maxwellfairman/EMG-Signal-Conditioning-and-Monitoring-System/EMG circuit testing/Rectified Signal.jpg

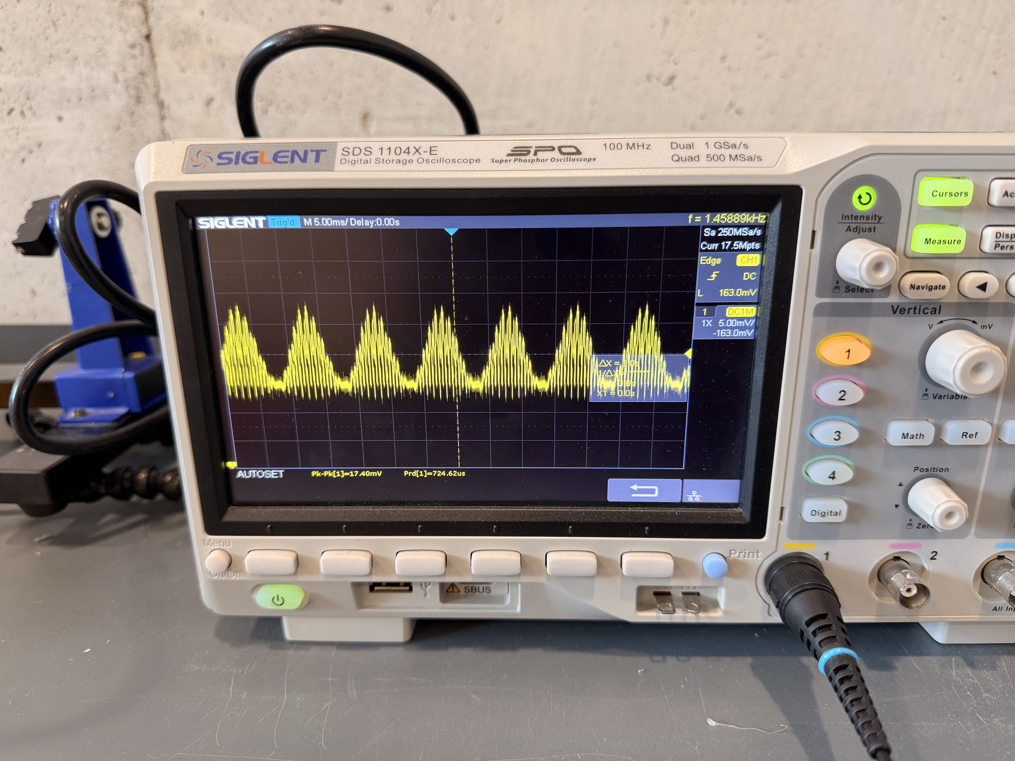
EMG circuit testing/Rectified Signal.jpg
