maxwellfairman/EMG-Signal-Conditioning-and-Monitoring-System/EMG circuit testing/Signal after lowpass filter.jpg

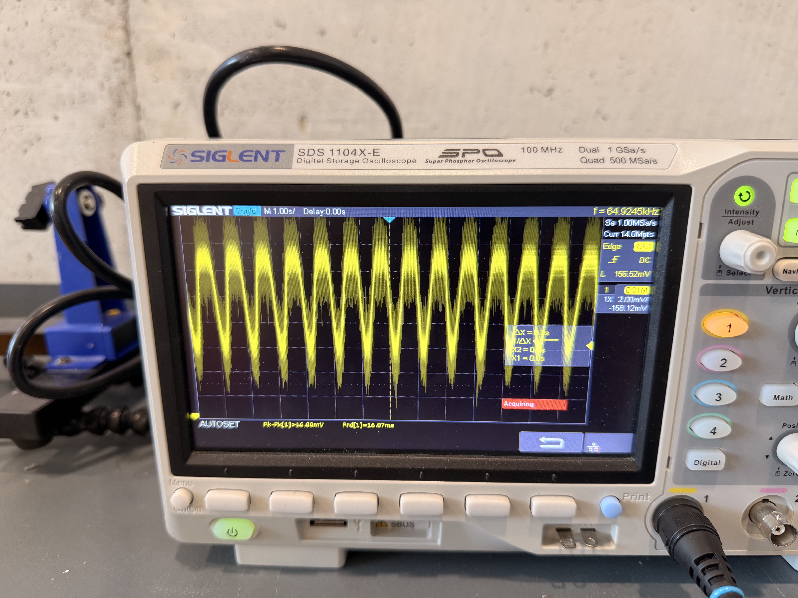
EMG circuit testing/Signal after lowpass filter.jpg
