maxwellfairman/EMG-Signal-Conditioning-and-Monitoring-System/EMG LTSpice simulations/Circuit diagram.png

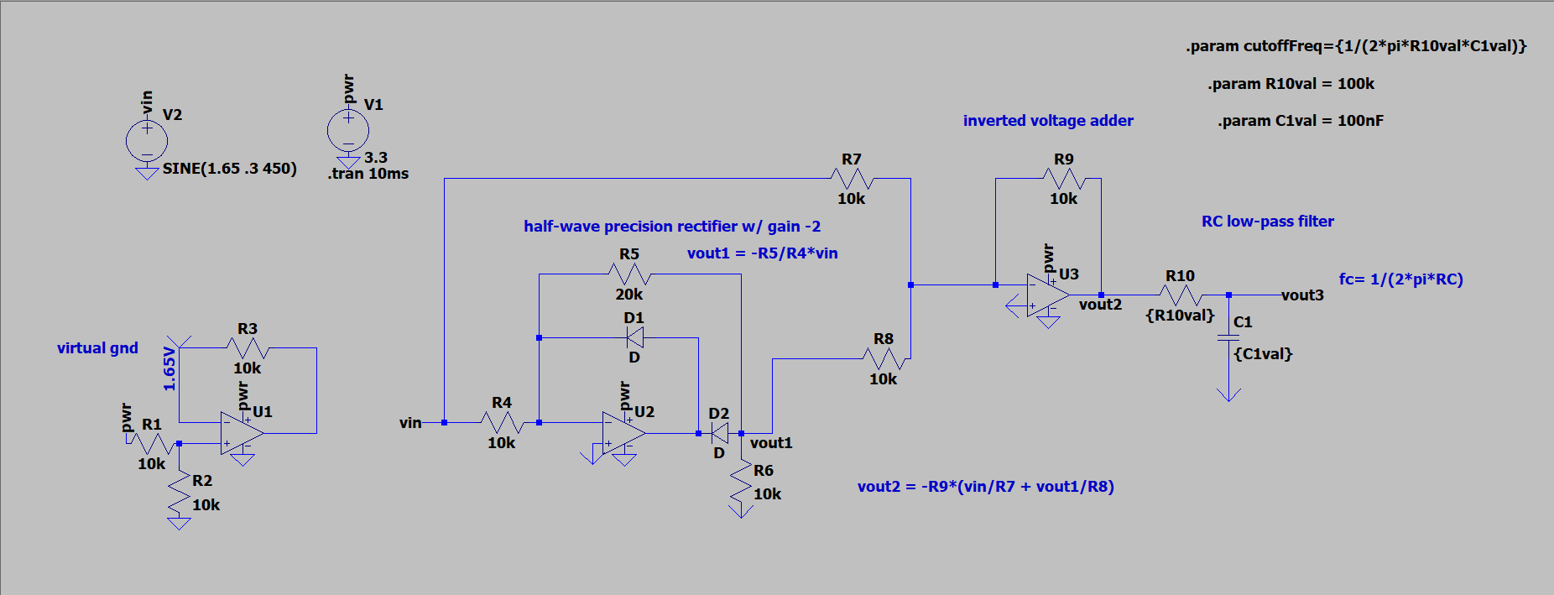
EMG LTSpice simulations/Circuit diagram.png
