maxwellfairman/EMG-Signal-Conditioning-and-Monitoring-System/EMG LTSpice simulations/Transient Analysis.png

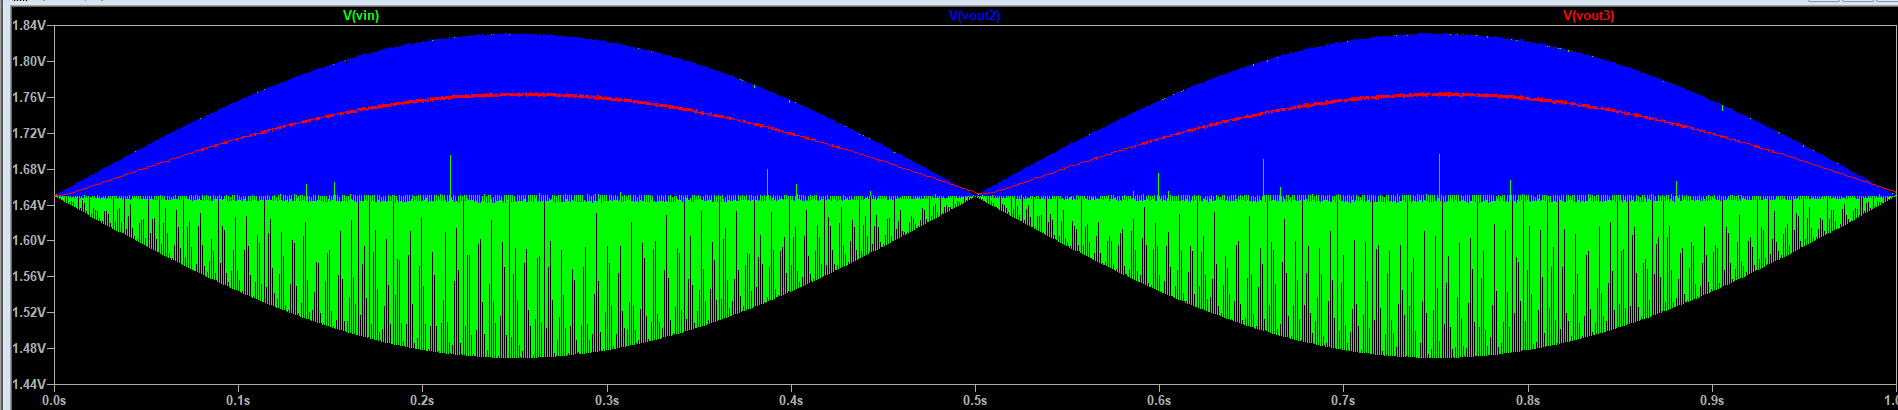
EMG LTSpice simulations/Transient Analysis.png
