maxwellfairman/EMG-Signal-Conditioning-and-Monitoring-System/EMG LTSpice simulations/emg circuit diagram.asc

C1: cap; {C1val}
D1: diode
D2: diode
R1: res; 10k
R2: res; 10k
R3: res; 10k
R4: res; 10k
R5: res; 20k
R6: res; 10k
R7: res; 10k
R8: res; 10k
R9: res; 10k
R10: res; {R10val}
R12: res; 100k
U1: UniversalOpAmp2
U2: UniversalOpAmp2
U3: UniversalOpAmp2
V1: voltage; 3.3
V2: voltage; SINE(1.65 .3 450)
Named nets: pwr, 0, COM, vin, vout1, vout2, vout3
.tran 10ms
virtual gnd
vout1 = -R5/R4*vin
half-wave precision rectifier w/ gain -2
inverted voltage adder
RC low-pass filter
.param R10val = 100k
.param C1val = 100nF
.param cutoffFreq={1/(2*pi*R10val*C1val)}
vout2 = -R9*(vin/R7 + vout1/R8)
fc= 1/(2*pi*RC)
