maxwellfairman/EMG-Signal-Conditioning-and-Monitoring-System/EMG circuit testing/Function Generator Signal.jpg

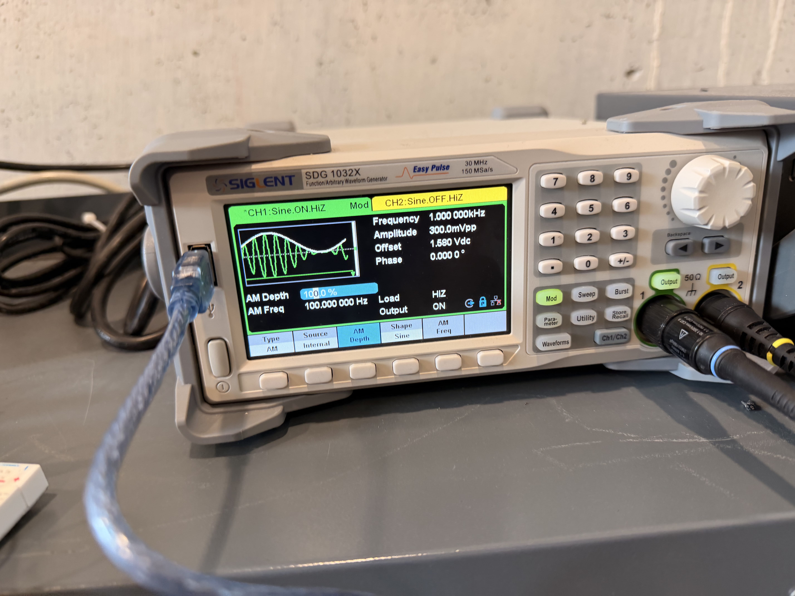
EMG circuit testing/Function Generator Signal.jpg
