maxwellfairman/EMG-Signal-Conditioning-and-Monitoring-System/EMG circuit testing/Labeled Breadboard Circuit.png

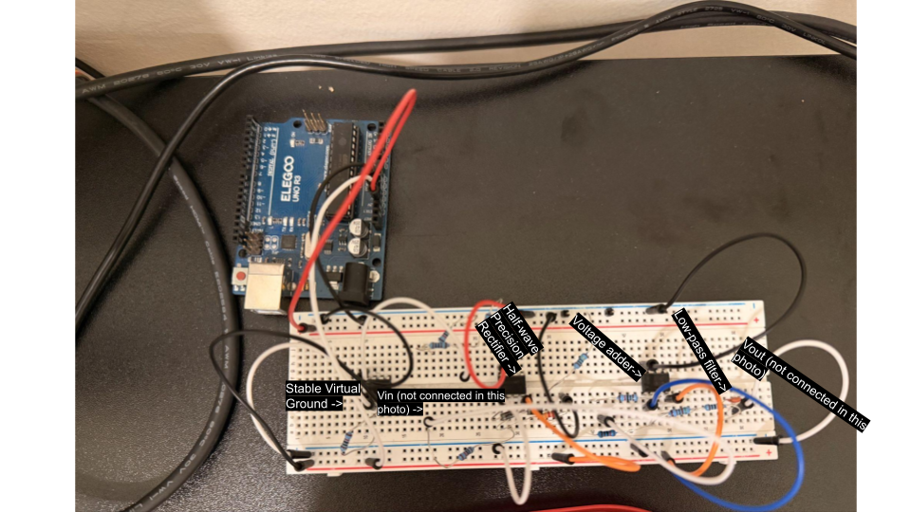
EMG circuit testing/Labeled Breadboard Circuit.png
