maxwellfairman/EMG-Signal-Conditioning-and-Monitoring-System/Myoware Testing/Myoware and Buzzer circuit.png

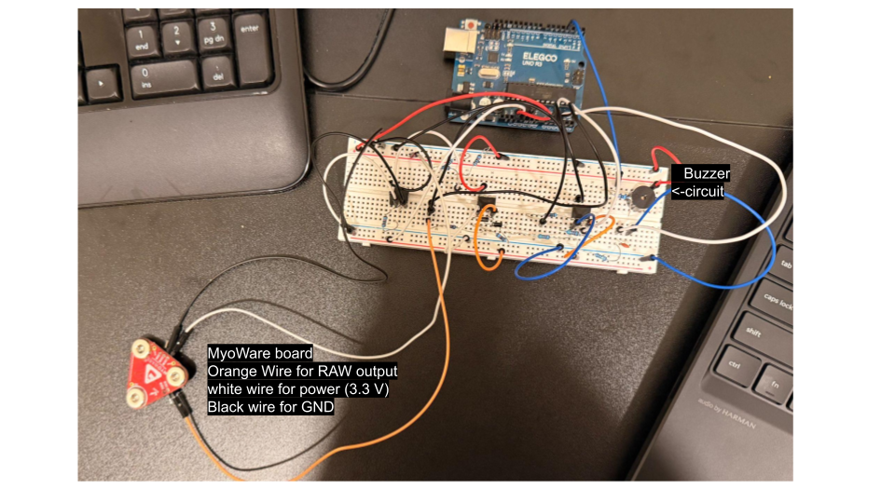
Myoware Testing/Myoware and Buzzer circuit.png
