maxwellfairman/EMG-Signal-Conditioning-and-Monitoring-System/(commit log)

2026-07-21 Rename Screenshot 2026-07-21 111414.png to Circuit Diagram.png
2026-07-21 Rename emg circuit diagram.asc to Circuit diagram.asc
2026-07-21 Rename IMG_8630.jpg to Circuit on breadboard.jpg
2026-07-21 Rename IMG_8625.jpg to Signal after lowpass filter.jpg
2026-07-21 Rename Untitled presentation.png to Labeled Breadboard Circuit.png
2026-07-21 Rename Untitled presentation (1).png to Myoware and Buzzer circuit.png
